NoharEddala/Electronic_Load_FuelCell/Images/smd components soldered.JPG

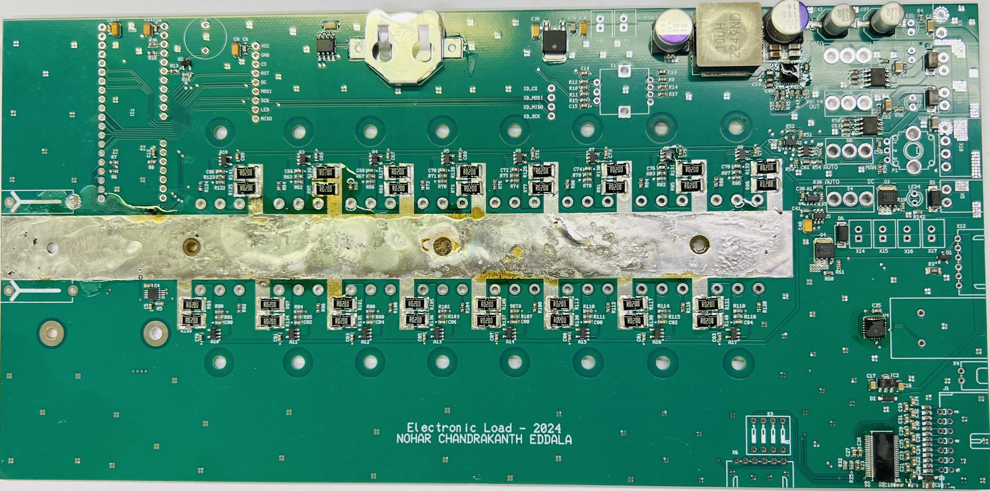
Images/smd components soldered.JPG
