NoharEddala/Electronic_Load_FuelCell/Hardware/5vldo.jpg

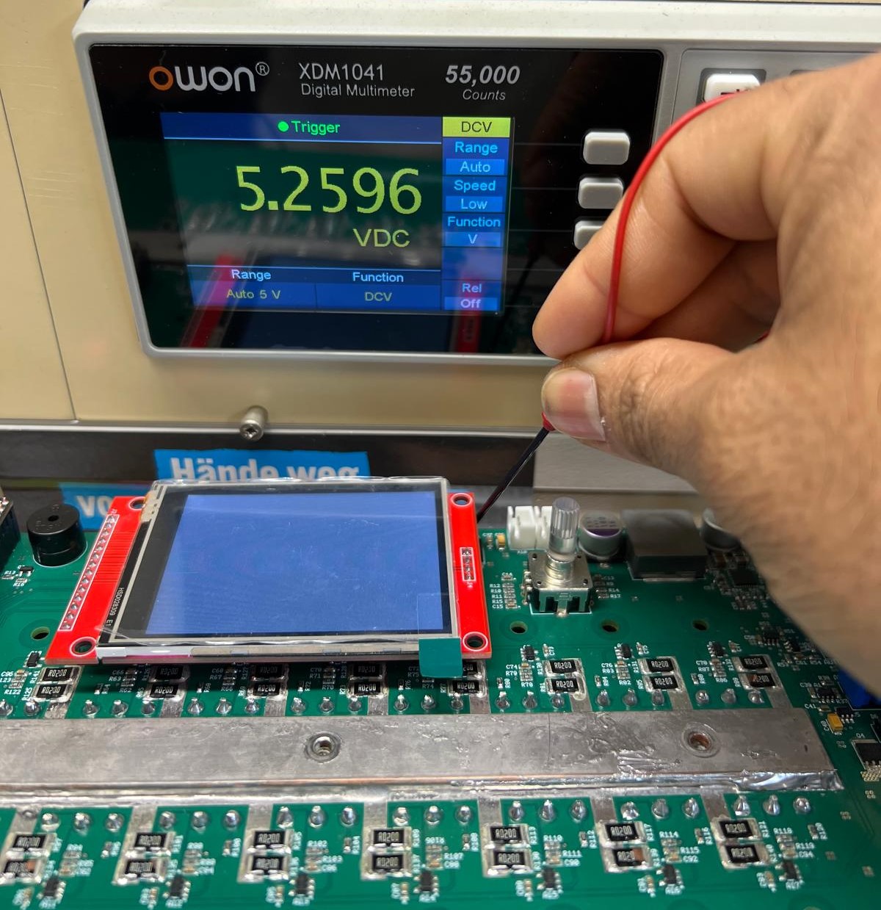
Hardware/5vldo.jpg
