NoharEddala/Electronic_Load_FuelCell/README.md

# ⚡ Electronic Load for Fuel Cell Characterization

**Goal:**  
To design and develop an electronic load with integrated controls for real-time testing of automotive fuel cell stacks up to 160 A.

---

## 🔧 Overview
This project was developed as part of my Master’s Thesis at **Institut für Regenerative Energie Systeme (Thaiger H2 Racing)**.  
It provides a programmable electronic load system capable of evaluating hydrogen fuel cell stacks under various operating conditions.

The setup integrates:
- Designed Schematics and PCB development in Altium Designer
- Designed Analog & digital circuits, Power supply circuits, ADC/DAC and PWM control circuits
- ESP32 microcontroller for measurement and control  
- Real-time monitoring of stack performance

---

## 🧩 System Architecture
- **Hardware:** Multi-layer PCB designed in *Altium 365*, ensuring EMC compliance and signal integrity  
- **Firmware:** Written in *C/C++* for the ESP32, handling sensor input and digital load control  
- **Communication:** I²C / SPI interfaces for peripheral integration  
- **Measurement:** Voltage, current, Power and temperature monitoring of fuel cell 



---

## ⚙️ Key Features
- Current regulation up to **160 A** with high stability  
- Closed-loop control using PWM and ADC feedback  
- Modular design for easy adaptation to different load ranges  
- Full documentation and test data included  

---

## 🛠 Tools & Technologies
| Category | Tools |
|---|---|
| Schematic & PCB Design | Altium Designer |
| Firmware | Arduino IDE (C/C++) |
| Testing | Oscilloscope, Logic Analyzer |

---

## 📁 Repository Structure

Hardware/ → schematics, PCB exports, BOM
Firmware/ → ESP32 source code and libraries
Docs/ → thesis report, user manual, and test data
Images/ → setup photos, measurement graphs

---

## 👨‍🔬 My Contribution
I was responsible for **end-to-end development**:
- Designed analog and digital hardware circuits
- Created PCB layout and validated EMC performance
- Soldered SMD and THT components
- Developed firmware for current control and data acquisition  
- Documented and tested the final product  

---

## 📈 Results
- Achieved stable dynamic current response under varied load conditions  
- Verified accuracy of current measurement within ±2%  
- Integrated safety cutoff and thermal monitoring  

---

## 🪪 License
MIT License — feel free to reference or adapt for educational purposes.  

---

*© 2024 Nohar Chandrakanth Eddala — Developed as part of Master’s Thesis in Renewable Energy & E-Mobility at Hochschule Stralsund.*
