NoharEddala/Electronic_Load_FuelCell/Hardware/12V dcdc.jpg

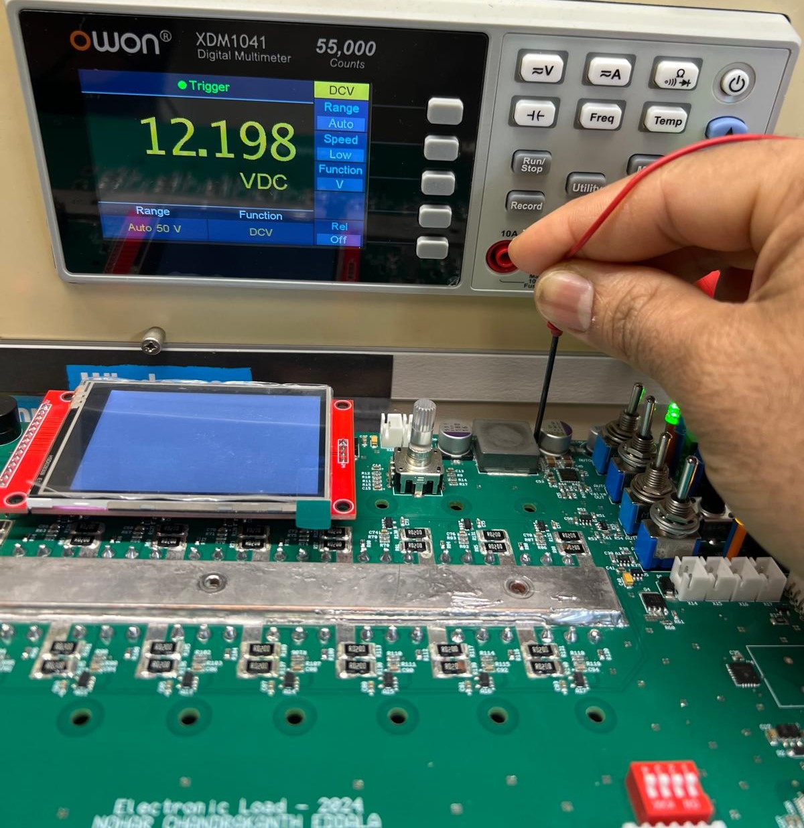
Hardware/12V dcdc.jpg
