NoharEddala/Electronic_Load_FuelCell/Hardware/Blockdiagram.PNG

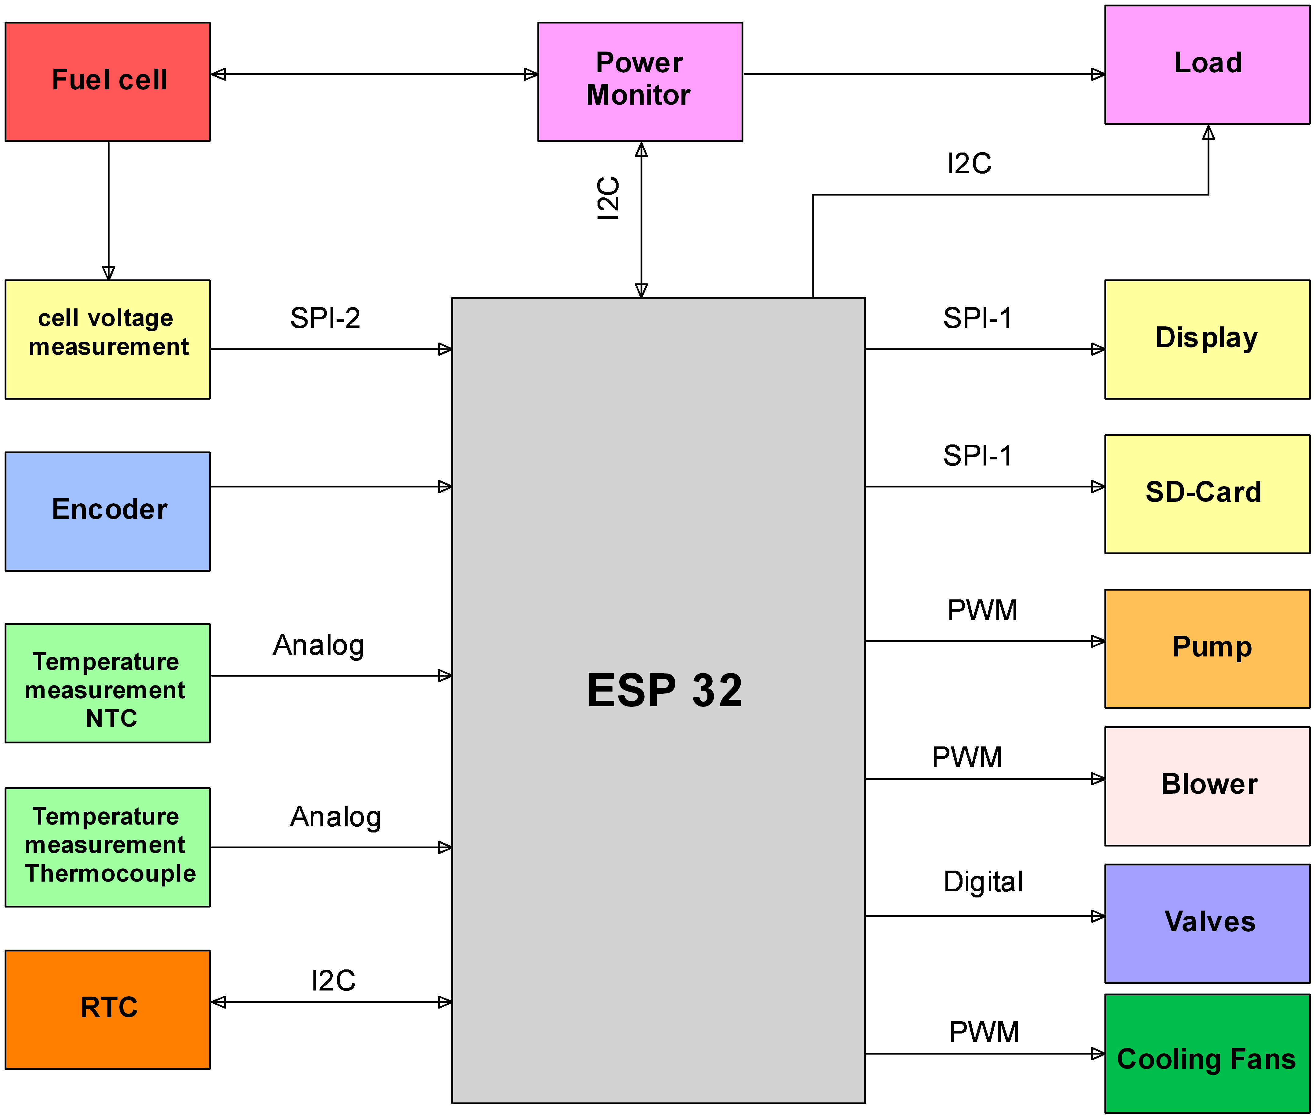
Hardware/Blockdiagram.PNG
