NoharEddala/Electronic_Load_FuelCell/Hardware/load2.jpeg

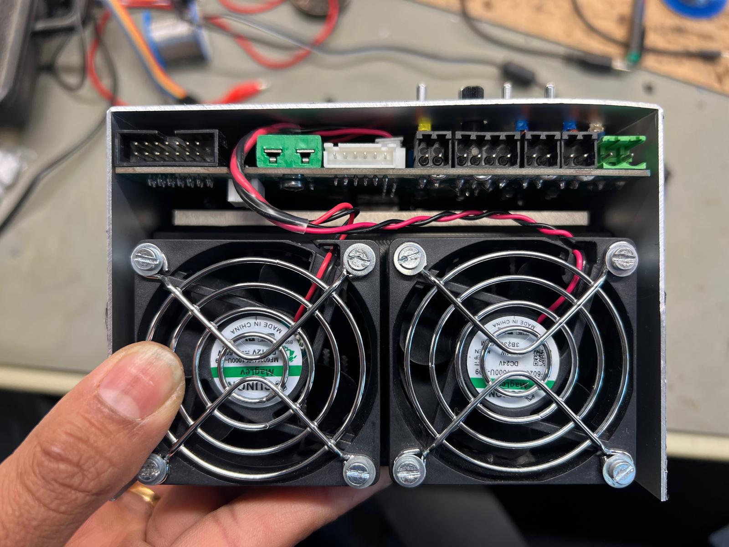
Hardware/load2.jpeg
