NoharEddala/Electronic_Load_FuelCell/Hardware/load.jpeg

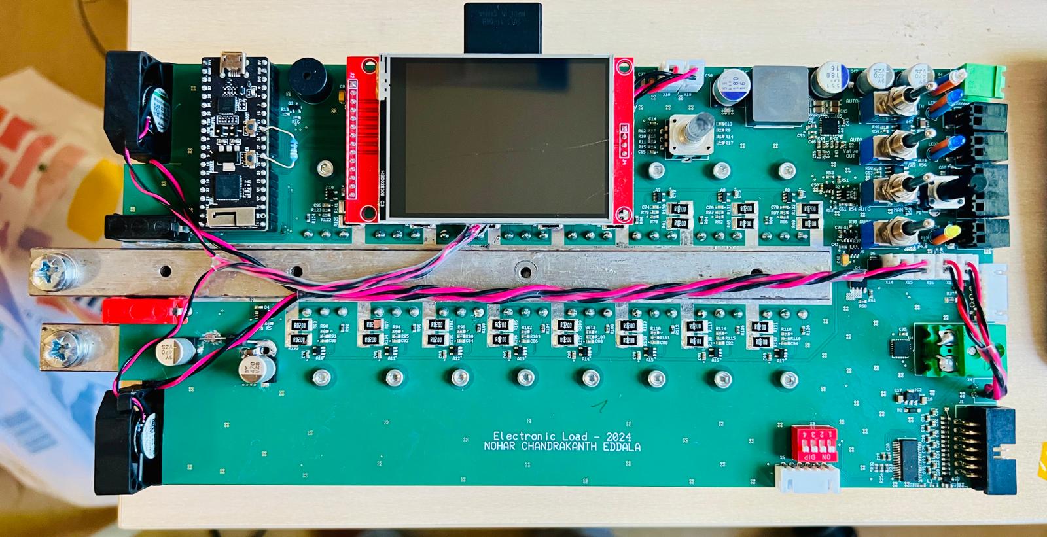
Hardware/load.jpeg
