NoharEddala/Electronic_Load_FuelCell/Hardware/Picture1.png

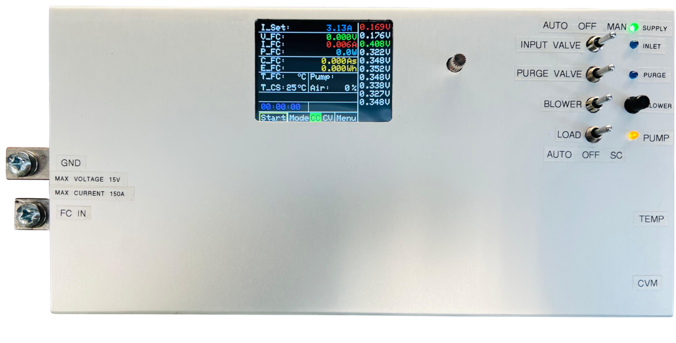
Hardware/Picture1.png
