NoharEddala/Electronic_Load_FuelCell/Images/Allcontrols described .png

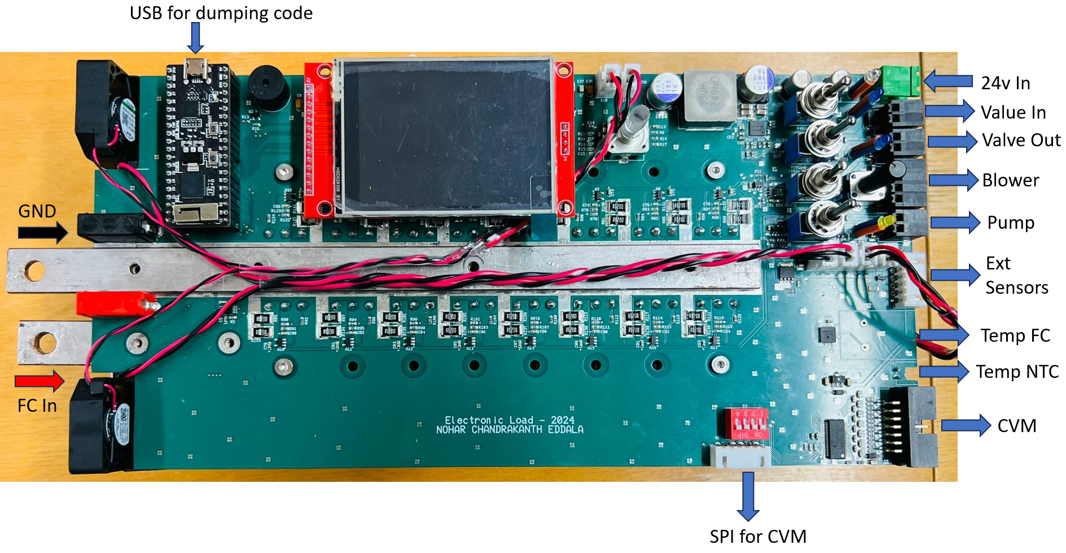
Images/Allcontrols described .png
