NoharEddala/Electronic_Load_FuelCell/Images/Image.jpeg

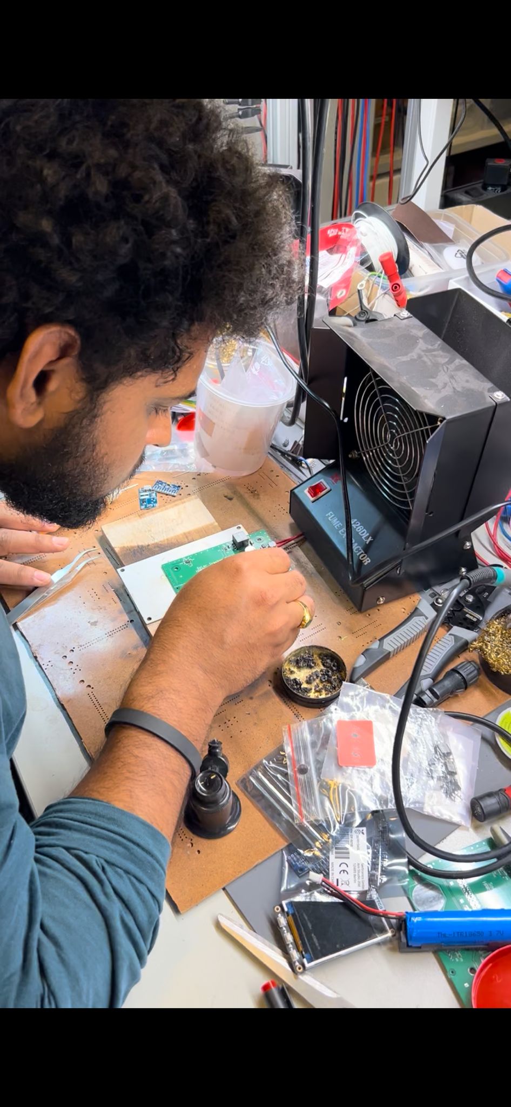
Images/Image.jpeg
