NoharEddala/Electronic_Load_FuelCell/Images/IMG_E3417.JPG

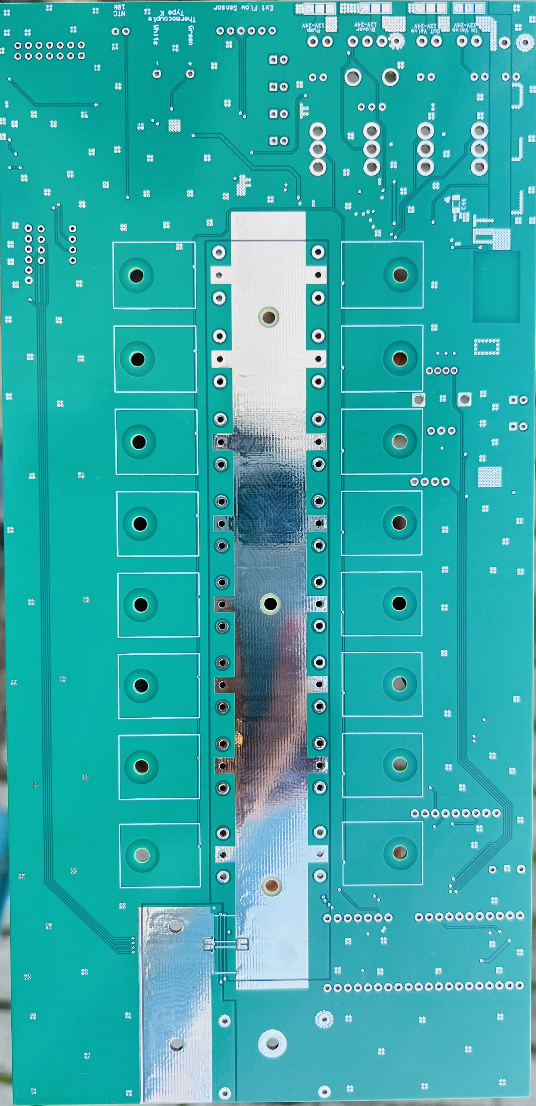
Images/IMG_E3417.JPG
